athi94/sunswift.current-integrator/calibration/24-09-2011-currentint1.ods

Sheet: Sheet1
scandal | voltage | current | resistance | error | error | Notes: Current integrator 1, PGA ON, Temperature ~20degrees C
-1083 | 0 | 0 |  | -24.4301409999998 |  | Resistance | 0.407800514314181
-1818 | -820.9 | -2013 | 0.407799304520616 | -35.4194859999998
-2579 | -1672.3 | -4099.8 | 0.40789794624128 | -44.2057329999998
-3307 | -2487.8 | -6100 | 0.407836065573771 | -48.7189889999991
-4013 | -3277 | -8037 | 0.407739206171457 | -55.8502509999998
-4722 | -4072 | -9987 | 0.407730049063783 | -58.2426940000005
-6778 | -6377 | -15637.5477130639 | 0.407800514314181 | -69.3576929361188
-8356 | -8150 | -19985.2617000895 | 0.407800514314181 | -67.024911910521
-10187 | -10209 | -25034.2989811305 | 0.407800514314181 | -60.0617678695053
-12084 | -12345 | -30272.1540720987 | 0.407800514314181 | -46.0267959012635
-13943 | -14442 | -35414.3741684285 | 0.407800514314181 | -22.9851925714902
-15965 | -16727 | -41017.6039825027 | 0.407800514314181 | 12.2086275026668
-17427 | -18392 | -45100.4825997602 | 0.407800514314181 | 69.1383707602145
-19269 | -20492 | -50250.0592341391 | 0.407800514314181 | 146.3498711391
 |  | 0 | #DIV/0! | 2957.8562
 |  | 0 | #DIV/0! | 2957.8562
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
