athi94/sunswift.current-integrator/calibration/24-09-2011-currentint2.ods

Sheet: Sheet1
scandal | voltage reading | current reading | resistance | Current integrator 2, PGA ON
-937 | 0.9 | 2.6 | 0.3461538461538 | Temperature ~20degrees C
-847 | 102.8 | 252.5 | 0.4071287128713 | Resistance
-644 | 337.5 | 828 | 0.4076086956522 | 0.4078007085220
-516 | 485.1 | 1189.8 | 0.4077155824508
-238 | 811.5 | 1990 | 0.4077889447236
109 | 1214.5 | 2978 | 0.4078240429819
494 | 1663.3 | 4078.1 | 0.4078615041318
859 | 2086.4 | 5115 | 0.4078983382209
1174 | 2453.2 | 6015 | 0.4078470490441
1523 | 2861 | 7017 | 0.4077240986176
1872 | 3270 | 8018 | 0.4078323771514
2232 | 3692 | 9055 | 0.4077305356157
2533 | 4044 | 9917 | 0.4077846122819
4108 | 5893 | 14450.6860259228 | 0.4078007085220
6036 | 8157 | 20002.4174297391
7777 | 10210 | 25036.739237175
9498 | 12237 | 30007.3044118815
11266 | 14313 | 35098.026317501
13295 | 16720 | 41000.4192013287
14808 | 18522 | 45419.2442851082 |  | pos | M = | 3024670.67735777
16319 | 20306 | 49793.9301616136 |  |  | B = | 2709964.27989696
 |  | 0 |  | neg | M =
-18364 | -20545 | -50380.0007470872 | 0.4078007085220 |  | B =
-16669 | -18543 | -45470.7400269281 | 0.4078007085220 | together | M = | 3026029.57965996
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
