athi94/sunswift.current-integrator/calibration/24-09-2011.ods

scandal | voltage reading | current reading | resistance
−937 | 0.9 | 2.6 | 0.34615384615385 | 0.40780070852198
−847 | 102.8 | 252.5 | 0.40712871287129
−644 | 337.5 | 828 | 0.40760869565217
−516 | 485.1 | 1189.8 | 0.40771558245083
−238 | 811.5 | 1990 | 0.40778894472362
109 | 1214.5 | 2978 | 0.40782404298187
494 | 1663.3 | 4078.1 | 0.40786150413183
859 | 2086.4 | 5115 | 0.40789833822092
1174 | 2453.2 | 6015 | 0.40784704904406
1523 | 2861 | 7017 | 0.40772409861764
1872 | 3270 | 8018 | 0.40783237715141
2232 | 3692 | 9055 | 0.40773053561568
2533 | 4044 | 9917 | 0.40778461228194
4108 | 5893 | 14450.6860259228 | 0.40780070852198
6036 | 8157 | 20002.4174297391
7777 | 10210 | 25036.739237175
9498 | 12237 | 30007.3044118815
11266 | 14313 | 35098.026317501
13295 | 16720 | 41000.4192013287
14808 | 18522 | 45419.2442851082
16319 | 20306 | 49793.9301616136
 |  | 0
