athi94/sunswift.current-integrator/calibration/07-09-2011.ods

Current | Reading | Current | Reading
0 | -1042 | 0 | -1042 | 0
-0.43 | -1198 | 0.7 | -769 | 700
-0.7 | -1311 | 0.81 | -740 | 810
-1.54 | -1600 | 1 | -670 | 1000
-1.6 | -1635 | 1.23 | -570 | 1230
-1.75 | -1686 | 1.53 | -471 | 1530
-2.59 | -2005 | 2 | -298 | 2000
-3.04 | -2170 | 2.29 | -198 | 2290
-3.25 | -2252 | 3.59 | 290 | 3590
-3.44 | -2320 | 3.79 | 375 | 3790
-5.49 | -3080 | 4.83 | 750 | 4830
-5.71 | -3160 | 5.01 | 820 | 5010
-6.03 | -3281 | 5.18 | 870 | 5180
-6.38 | -3410 | 5.49 | 1002 | 5490
-6.8 | -3560 | 5.8 | 1112 | 5800
-7.45 | -3811 | 6.09 | 1210 | 6090
-7.75 | -3922 | 7.31 | 1687 | 7310
-8.13 | -4055 | 8.44 | 2101 | 8440
-8.33 | -4120 | 9.14 | 2350 | 9140
-8.66 | -4256 | 9.44 | 2466 | 9440
-9.86 | -4700 | 9.56 | 2505 | 9560
-10.7 | -5010 | 10.71 | 2940 | 10710
-11.64 | -5365 | 11.2 | 3120 | 11200
-12.08 | -5515 | 12.61 | 3630 | 12610
 |  |  |  | 0
 |  |  |  | 0
 |  |  |  | 0
 |  |  |  | 0
 |  |  |  | 0
 |  |  |  | 0
 |  |  |  | 0
 |  |  |  | 0
 |  |  |  | 0
 |  |  |  | 0
 |  |  |  | 0
 |  |  |  | 0
 |  |  |  | 0
 |  |  |  | 0
 |  |  |  | 0
 |  |  |  | 0
 |  |  |  | 0
 |  |  |  | 0
 |  |  |  | 0
 |  |  |  | 0
 |  |  |  | 0
 |  |  |  | 0
 |  |  |  | 0
 |  |  |  | 0
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
