athi94/sunswift.current-integrator/calibration/10-09-2011.ods

Sheet: Sheet1
scandal | reading | scandal | reading
-1083 | -1 | -1083 | 1
-1062 | 56 | -1090 | -17
-998 | 230 | -1136 | -144
-980 | 280 | -1186 | -279
-927 | 424 | -1208 | -339
-906 | 480 | -1229 | -398
-885 | 537 | -1276 | -525
-864 | 594 | -1310 | -616
-857 | 616 | -1326 | -661
-849 | 639 | -1346 | -717
-832 | 684 | -1379 | -805
-820 | 717 | -1388 | -828
-801 | 765 | -1432 | -954
-790 | 794 | -1455 | -1016
-782 | 816 | -1489 | -1108
-771 | 848 | -1515 | -1179
-747 | 912 | -1536 | -1236
-732 | 955 | -1543 | -1256
-717 | 995 | -1556 | -1289
-709 | 1016 | -1568 | -1324
-679 | 1097 | -1589 | -1381
-650 | 1177 | -1609 | -1437
-635 | 1216 | -1636 | -1511
-624 | 1246 | -1650 | -1549
-613 | 1275 | -1680 | -1629
-592 | 1333 | -1693 | -1665
-564 | 1408 | -1700 | -1682
-543 | 1465 | -1705 | -1699
-506 | 1564 | -1708 | -1707
-482 | 1629 | -1711 | -1716
-460 | 1689 | -1726 | -1758
-433 | 1758 | -1733 | -1777
-412 | 1817 | -1754 | -1835
-399 | 1851 | -1767 | -1869
-379 | 1909 | -1802 | -1967
-362 | 1950 | -1815 | -2000
-357 | 1967 | -1833 | -2049
-337 | 2023 | -1844 | -2080
-324 | 2057 | -1853 | -2103
-311 | 2095 | -1861 | -2127
-305 | 2110 | -1870 | -2152
-295 | 2141 | -1884 | -2189
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
