athi94/sunswift.current-integrator/calibration/14-09-2011.ods

scandal | voltage | current | scandal | voltage | current | voltage | current
-1089 | 0.9 | 2.20569640489315 | -1091 | 0 | 0 | 57.3 | 140.2 | 0.408701854493581 | 0.40803439585041
-723 | 408.8 | 1001.87632257813 | -1455 | -408.4 | -1000.89601306485 | 113.3 | 277.5 | 0.408288288288288
-338 | 831.9 | 2038.79871025624 | -1825 | -821.1 | -2012.33035339752 | 159.1 | 389.8 | 0.408158029758851
80 | 1295.6 | 3175.22251353285 | -2186 | -1223.8 | -2999.25695589804 | 220.3 | 539.8 | 0.408114116339385
372 | 1621.8 | 3974.66492161746 | -2544 | -1626.3 | -3985.69340364193 | 306.9 | 752.1 | 0.408057439170323
761 | 2049.5 | 5022.86086869835 | -2909 | -2034 | -4984.87387505853 | 337.5 | 827.3 | 0.407953583947782
1118 | 2447.3 | 5997.77867966113 | -3286 | -2457.2 | -6022.04134011495 | 403.7 | 989.5 | 0.407983830217281
1487 | 2860.1 | 7009.45809737212 | -3637 | -2849.3 | -6982.9897405134 | 449.4 | 1101.7 | 0.407915040392121
1857 | 3273 | 8021.38259246143 | -4016 | -3274 | -8023.83336624465 | 56.7 | 138.8 | 0.40850144092219
2284 | 3751 | 9192.85246083802 | -4385.5 | -3688 | -9038.4537124955 | 67 | 164.2 | 0.408038976857491
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
