athi94/sunswift.current-integrator/(list of files, drawings)

Other design files:
hardware/2011_CurrentIntegrator2.PcbDoc
hardware/2011_CurrentIntegrator.PrjPcb
hardware/LPC_Rep.SchDoc
hardware/MCP3909.SchDoc
hardware/TopLevel.SchDoc
