athi94/sunswift.current-integrator/firmware/include/project/target_config.h

/****************************************************************************
 *   $Id:: target_config.h 4832 2010-09-07 23:04:21Z nxp21346                 $
 *   Project: LED flashing / ISP test program
 *
 *   Description:
 *     This file contains the config settings for the blinky code sample
 *     which flashes an LED on the LPCXpresso board and also increments an
 *     LED display on the Embedded Artists base board. This project
 *     implements CRP and is useful for testing bootloaders.
 *
 ****************************************************************************
 * Software that is described herein is for illustrative purposes only
 * which provides customers with programming information regarding the
 * products. This software is supplied "AS IS" without any warranties.
 * NXP Semiconductors assumes no responsibility or liability for the
 * use of the software, conveys no license or title under any patent,
 * copyright, or mask work right to the product. NXP Semiconductors
 * reserves the right to make changes in the software without
 * notification. NXP Semiconductors also make no representation or
 * warranty that such application will be suitable for the specified
 * use without further testing or modification.
****************************************************************************/

#define RED_LED_PORT 				2		// Port for led
#define RED_LED_BIT 				6		// Bit on port for led
#define YELLOW_LED_PORT 			2		// Port for led
#define YELLOW_LED_BIT 				0		// Bit on port for led
#define LED_TOGGLE_TICKS 		  	100 	// 100 ticks = 1 Hz flash rate
#define FAST_LED_TOGGLE_TICKS 		25 		// 100 ticks = 1 Hz flash rate
#define COUNT_MAX					3 		// how high to count on the LED display

#define DATA_SEND_INTERVAL			500		// 500ms
#define DATA_SAVE_INTERVAL			1000	// 10 minutes 600000
#define DATA_INTEGRATE_INTERVAL		100		// 100ms (MUST BE SMALLER THAN DATA_SEND_INTERVAL)

#define RESET_INTEGRAL				1
/*********************************************************************************
**                            End Of File
*********************************************************************************/
