athi94/sunswift.current-integrator/firmware/src/mcp3909.c

#include <project/hardware.h>
#include <scandal/timer.h>
#include <scandal/leds.h>
#include <scandal/utils.h>

#include <project/driver_config.h>
#include <arch/gpio.h>
#include <arch/ssp.h>
#include <project/mcp3909.h>

#define MULT_OUT  0xA1
#define MULT_OUT2 0xA9
#define DUAL_PRE  0xA4
#define DUAL_POST 0xAC
#define TIMEOUT 100000

void timer_delay(uint32_t ms){
  uint32_t timer; 
  uint32_t compare = 0; 
  timer = sc_get_timer();
 
  while(compare < timer)
    compare = sc_get_timer() - ms;
}


void delay(uint32_t count){
  volatile uint32_t i; 
  
  for(i=count; i>0; i--)
    ;
}

void mcp3909_init(void){
  SSP_IOConfig(1);
  SSP_Init(1); 

  /* Apply a 1s reset pulse to nMCLR */ 
  GPIO_SetValue(2,nMCLR,0);
  scandal_naive_delay(20);
  GPIO_SetValue(2,nMCLR,1);

  GPIO_SetValue(2,PGA,0);

  uint8_t mode = DUAL_PRE;
  SSP_Send(1,&mode,1);
  GPIO_SetValue(0,MCP3909_CS,1);

  scandal_naive_delay(100); 

}


int mcp3909_sample(int16_t* chan0, int16_t* chan1){
  uint8_t bytes[4]; 
  uint32_t i = 0;
  int returnVal = MCP3909_SUCCESS;

  GPIO_SetValue(0,MCP3909_CS,0);

  LPC_IOCON->PIO2_2 &= ~0x07; //set P2.2 to GPIO mode, to read dataready from MCP3909
  
  while((GPIO_GetValue(2, 2) == 0) && (i < TIMEOUT)){
    i++;    
  }
  /* We do not re-initialise i as failing once means we no longer care! */
  while((GPIO_GetValue(2, 2) != 0) && (i < TIMEOUT)){
    i++;
  }
  
  if (i >= TIMEOUT){
    returnVal = MCP3909_FAIL;
  }
  
  LPC_IOCON->PIO2_2 |= 0x02; //set P2.2 to MISO mode, to read actual data from MCP3909
 
  scandal_naive_delay(100);
  SSP_Receive(1, bytes, 4);

  GPIO_SetValue(0,MCP3909_CS,1);

  *chan1 = 
    ((int16_t)bytes[0] << 8 | 
     (int16_t)bytes[1]);
  *chan0 = 
    ((int16_t)bytes[2] << 8 | 
     (int16_t)bytes[3]);
    
    return returnVal;
}
