athi94/sunswift.current-integrator/firmware/src/leds.c

/* --------------------------------------------------------------------------
	Scandal Engine
	File name: led.c
	Author: Etienne Le Sueur
 
    Copyright (C) 2011 Etienne Le Sueur.

	Date: 29/08/2011
   -------------------------------------------------------------------------- */ 

/* 
 * This file is part of Scandal.
 * 
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
 * You should have received a copy of the GNU General Public License
 * along with Scandal.  If not, see <http://www.gnu.org/licenses/>.
 */

#include <scandal/types.h>

#include <project/driver_config.h>
#include <project/target_config.h>

#include <arch/gpio.h>

/* this is using two different levels of abstraction to twiddle the LEDs. We can
 * probably go even further up down thr rabbit hole to just modifying registers
 */

void red_led(u08 on) {
	if (on)
		GPIO_SetValue(2,6,0);
	else
		GPIO_SetValue(2,6,1);
}

void toggle_red_led(void) {
	LPC_GPIO[RED_LED_PORT]->MASKED_ACCESS[(1<<RED_LED_BIT)] ^= (1<<RED_LED_BIT);
}

void yellow_led(u08 on) {
	if (on)
		GPIO_SetValue(2,0,0);
	else
		GPIO_SetValue(2,0,1);
}

void toggle_yellow_led(void) {
	LPC_GPIO[YELLOW_LED_PORT]->MASKED_ACCESS[(1<<YELLOW_LED_BIT)] ^= (1<<YELLOW_LED_BIT);
}
