athi94/sunswift.current-integrator/(commit log)

2011-09-05 set to correct node type, removed some cruft
    [main.c]
2011-09-11 I cleaned up the code a bit, included integration, but needs fixing
    [main.c, mcp3909.c, target_config.h]
2011-09-27 Lots of stuff
    [07-09-2011.ods, 10-09-2011.ods, 14-09-2011.ods, 24-09-2011-currentint1.ods, 24-09-2011-currentint2.ods, 24-09-2011.csv, 24-09-2011.ods, blah.csv]
2012-05-07 Updated the hardware files to the latest version found in the mailing list threads.
    added hardware/2011_CurrentIntegrator.PrjPcb
    added hardware/2011_CurrentIntegrator2.PcbDoc
    added hardware/3V-Switcher-50mA.SCHDOC
    added hardware/3V3-CAN-UNISOLATED.SchDoc
    added hardware/LPC_Rep.SchDoc
    added hardware/MCP3909.SchDoc
    added hardware/TopLevel.SchDoc
    [2011_CurrentIntegrator.PrjPcb, 2011_CurrentIntegrator2.PcbDoc, 3V-Switcher-50mA.SCHDOC, 3V3-CAN-UNISOLATED.SchDoc, LPC_Rep.SchDoc, MCP3909.SchDoc, TopLevel.SchDoc]
2012-05-07 Removing old files from hardware
    [3V-Switcher-50mA.SchDoc, 3V3-CAN-Unisolated.SchDoc, CAN_faceplate.PcbDoc, lpc11c14.SchDoc, lpc1768.SchDoc, project_name.PcbDoc, project_name.PrjPcb, project_name_faceplate.PcbDoc]
2012-11-10 Made the reading more reliable with re-inits after a read failiure
    [main.c, mcp3909.c]
2013-01-06 Added LPC-FM24CL64 interfacing via I2C
    NOTE: Work in progress, working but with no backup/redundency
    NOTE: Memory reset on startup is set to true, needs to be off for live tests
    NOTE: Memory used so far is 0 - 1 for pointer, 2 - 2047 for data storage
    Added Files --
    fm24cl64.c - interface functions / back end helpers
    fm24cl64.h - Check this file for interface function usage
    Changed Files --
    Main.c - Hide Some UART Messages and added writing to FM24CL64
    target_config.h - changed DATA_SAVE_INTERVAL to 1 second from 10 minutes
    makefile - added OBJECT refering to fm24cl64.o
    [main.c, target_config.h]
2013-01-07 Switched from using the old sc_user_eeprom_read_block() to memRead()
    NOTE: Requires further testing
2013-01-07 Added a header for ANSI escape colors (Debug Readability). Changed certain UART prints to use color. included ansi_color.h in main.c included ansi_color.h in fm24cl64.c
    NOTE: To use ANSI colors;
    #include <project/ansi_color.h>
    UART_printf(ANSI_RED"This is Red"ANSI_RESET);
    Additional Colors defined in ansi_color.h
    NOTE: To see colors in minicom;
    sudo minicom -c on -b 115200 -D /dev/ttyUSB0
2013-02-15 Add checksum functionallity Data reverts to a previous version if check sum does not match.
    Rewritten writting sequence
    Now data is stored in blocks of 18 bytes
    8 bytes of chan0_int
    8 bytes of power_int
    2 bytes of CRC checksum
    [crc.c, fm24cl64.c, main.c]
